Gabrielleo2233/iot_water_monitoring/README.md

Olá!

Este projeto foi utilizado no meu TCC de engenharia elétrica.

O projeto tem o objetivo de disponibilizar dados de consumo de água em diferentes plataformas gratuitas. O projeto permite a visualização dos dados através do celular (Blynk iot) e computador (ThingSpeak). Além disso, possui integração com a plataforma Voiceflow, podendo ser usada junto com uma skill Alexa para gerar dados de valor para o usuário.

O código foi elaborado considerando o uso do microcontrolador ESP-01 em conjunto de um RTC3232 e um hidrômetro ultrassônico Hydrus 1.3. Futuramente o circuito eletrônico será disponibilizado no repositório.

O código foi desenvolvido na IDE do Arduino.

Existem fluxogramas no TCC, eles podem ajudar na compreensão do código.

O código pode ser otimizado, utilizando menos variáveis tipo "double" e funções menores.
